Ncerzzk/How_to_make_a_Flight/TIM配置.jpg

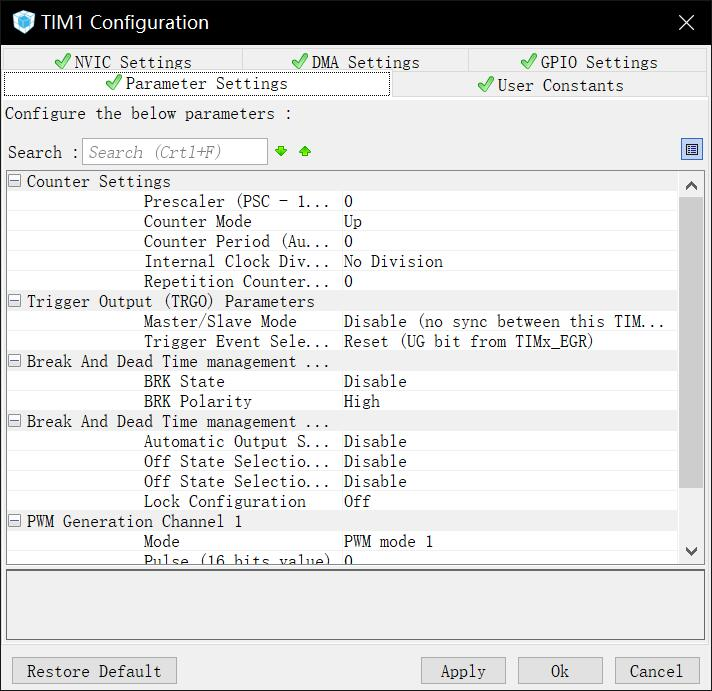
TIM配置.jpg
