Ncerzzk/How_to_make_a_Flight/串口配置.jpg

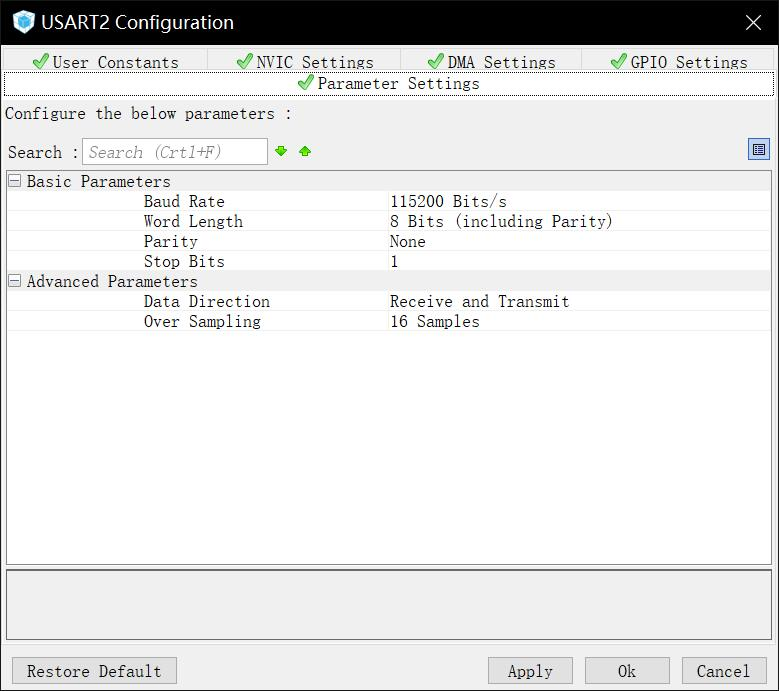
串口配置.jpg
