Ncerzzk/How_to_make_a_Flight/(list of files, drawings)

Other design files:
PCB/micro_flight.SchDoc
PCB/PCB.PcbDoc
PCB/PCB_Project.PrjPCB
